ktmizugaki/xiao-minichoc-sample/circuit/KeyboardLibrary/Keyboard.FCStd

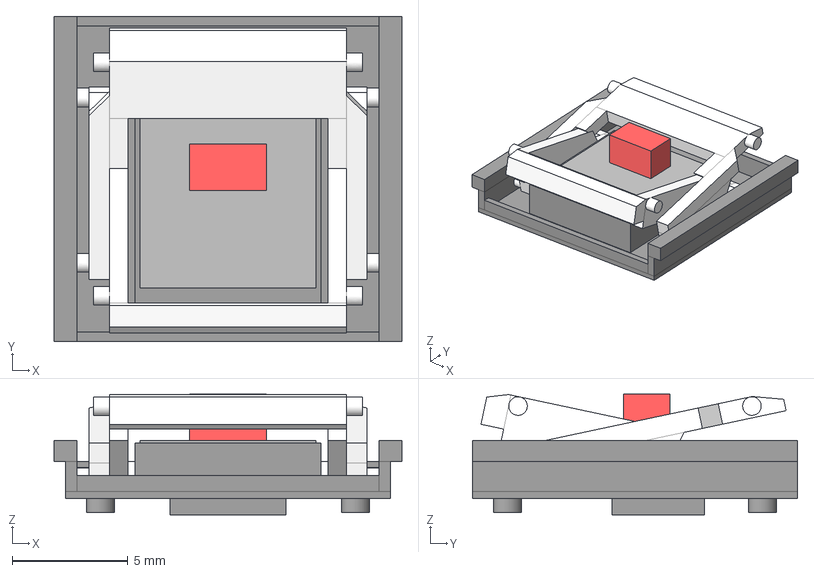
[picture p1: CAD file, 2022-06-24]
circuit/KeyboardLibrary/Keyboard.FCStd
15.0 x 14.0 x 5.20 mm
PG1425_Bottom
PG1425_TopPlate
PG1425_Stem
PG1425_FrontShaft
PG1425_BackShaft
