ktmizugaki/xiao-minichoc-sample/circuit/xiao-minichoc-sample.kicad_pcb

## KiCad design circuit/xiao-minichoc-sample.kicad_pcb (2022-06-24)

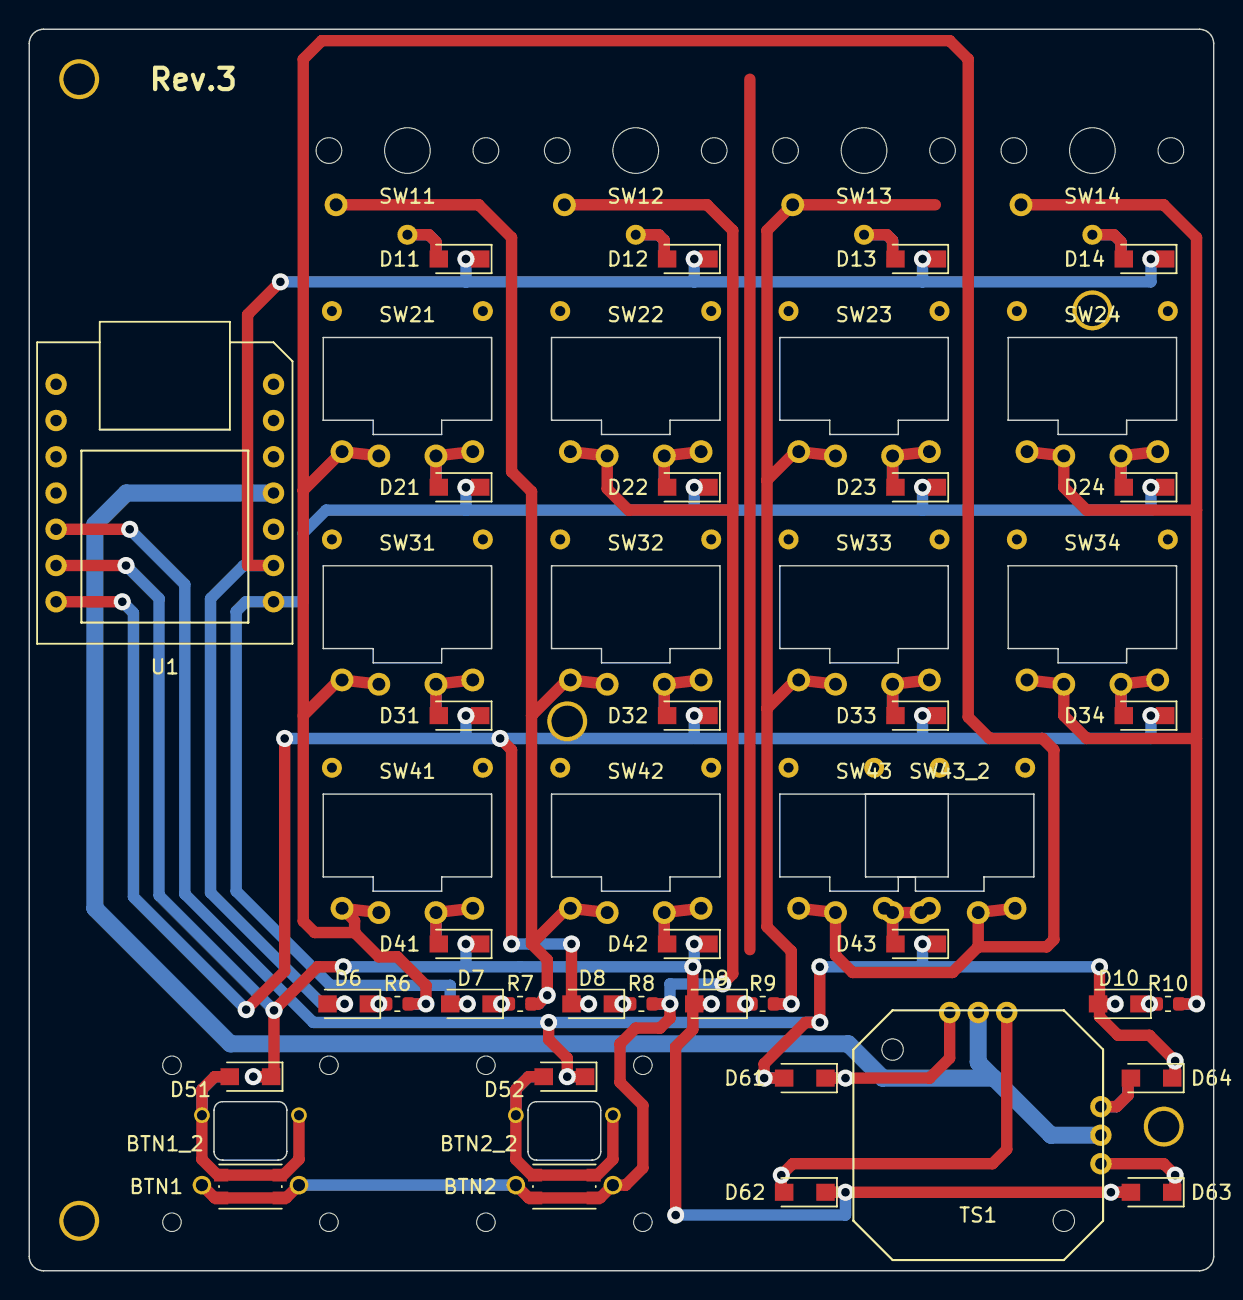
[picture p2: board xiao-minichoc-sample.kicad_pcb from above]

Board: 2 copper layers, 83.0 x 87.0 mm, 58 parts (0 on the bottom side), 37 nets.

Parts:
BTN1: BUTTON1; SW_SPST_KMR2
BTN1_2: BUTTON1; Kailh_X_Switch_PG1425_Reversible
BTN2: BUTTON2; SW_SPST_KMR2
BTN2_2: BUTTON2; Kailh_X_Switch_PG1425_Reversible
D6, D7, D8, D9, D10: 1SS355VM; D_SOD-123-323_Reversible
D11, D12, D13, D14, D21, D22, D23, D24, D31, D32, D33, D34, D41, D42, D43, D51, D52: 1N4148W; D_SOD-123-323_Reversible
D61, D62, D63, D64: SS2040FL; D_SOD-123-323_Reversible
Hole1: Hole1; MountingHole_2.2mm_M2_Pad
Hole2: Hole2; MountingHole_2.2mm_M2_Pad
Hole3: Hole3; MountingHole_2.2mm_M2_Pad
Hole4, Hole4#2: Hole4; MountingHole_2.2mm_M2_Pad
R6, R7, R8, R9, R10: ~~600; R_0603_1608Metric_Reversible
SW11: SW11; Kailh_Choc_V1_PG1350_Reversible
SW12: SW12; Kailh_Choc_V1_PG1350_Reversible
SW13: SW13; Kailh_Choc_V1_PG1350_Reversible
SW14: SW14; Kailh_Choc_V1_PG1350_Reversible
SW21: SW21; Kailh_Choc_Mini_PG1232_Reversible
SW22: SW22; Kailh_Choc_Mini_PG1232_Reversible
SW23: SW23; Kailh_Choc_Mini_PG1232_Reversible
SW24: SW24; Kailh_Choc_Mini_PG1232_Reversible
SW31: SW31; Kailh_Choc_Mini_PG1232_Reversible
SW32: SW32; Kailh_Choc_Mini_PG1232_Reversible
SW33: SW33; Kailh_Choc_Mini_PG1232_Reversible
SW34: SW34; Kailh_Choc_Mini_PG1232_Reversible
SW41: SW41; Kailh_Choc_Mini_PG1232_Reversible
SW42: SW42; Kailh_Choc_Mini_PG1232_Reversible
SW43, SW43_2: SW43; Kailh_Choc_Mini_PG1232_Reversible
TS1: JT8P-3.2T-B10K-1-16Y-2; JT8P-3.2T-B10K-1-16Y
U1: SeeeduinoXIAO; Seeeduino_XIAO_THT_UpsideDown

Connections:
/A0: TS1.x2, TS1.y2, U1.4
/D6: D6.2, D11.1, D12.1, D13.1, D14.1, U1.6
/D7: D7.2, D21.1, D22.1, D23.1, D24.1, U1.7
/D8: D8.2, D31.1, D32.1, D33.1, D34.1, Hole4#2.1, U1.8
/D9: D9.2, D41.1, D42.1, D51.1, D62.1, D63.2, U1.9
/D10: D10.2, D43.1, D52.1, D61.2, D64.1, U1.10
/RD6: R6.2, SW21.1, SW31.1, SW41.1, SW43.1, SW43_2.2
/RD7: R7.2, SW11.2, SW32.1, SW42.1
/RD8: BTN1.1, BTN1_2.1, BTN2.1, BTN2_2.1, R8.2, SW12.2, SW22.1
/RD9: R9.2, SW13.2, SW23.1, SW33.1
/RD10: R10.2, SW14.2, SW24.1, SW34.1
unnamed: BTN1.2, BTN1_2.2, D51.2
unnamed: BTN2.2, BTN2_2.2, D52.2
unnamed: D6.1, R6.1
unnamed: D7.1, R7.1
unnamed: D8.1, R8.1
unnamed: D9.1, R9.1
unnamed: D10.1, R10.1
unnamed: D11.2, SW11.1
unnamed: D12.2, SW12.1
unnamed: D13.2, SW13.1
unnamed: D14.2, SW14.1
unnamed: D21.2, SW21.2
unnamed: D22.2, SW22.2
unnamed: D23.2, SW23.2
unnamed: D24.2, SW24.2
unnamed: D31.2, SW31.2
unnamed: D32.2, SW32.2
unnamed: D33.2, SW33.2
unnamed: D34.2, SW34.2
unnamed: D41.2, SW41.2
unnamed: D42.2, SW42.2
unnamed: D43.2, SW43.2, SW43_2.1
unnamed: D61.1, TS1.x3
unnamed: D62.2, TS1.x1
unnamed: D63.1, TS1.y1
unnamed: D64.2, TS1.y3
