ktmizugaki/xiao-minichoc-sample/MeasureDiode/charlieplex-3io.png

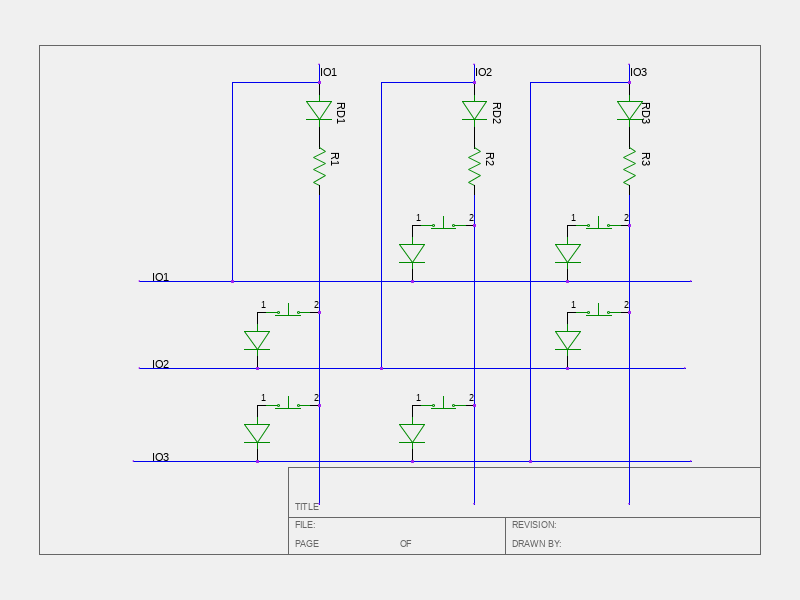
MeasureDiode/charlieplex-3io.png
