ktmizugaki/xiao-minichoc-sample/MeasureDiode/MeasureDiode-sch.png

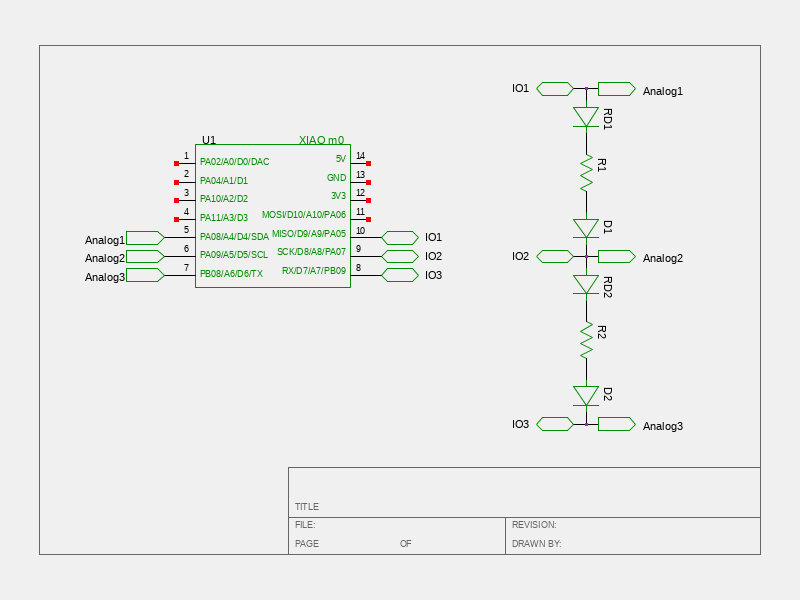
MeasureDiode/MeasureDiode-sch.png
