ktmizugaki/xiao-minichoc-sample/(commit log)

2022-06-24 Add KeyboardLibrary
    [Keyboard.FCStd]
2022-06-24 Add MeasureDiode
    [MeasureDiode.sch]
2022-06-24 Add png version of schematic
    [charlieplex-3io.sch]
2022-10-10 Rework firmware
    - Restructure sources
    - Refine analog handling
    - Support layer
    [kbdconfig.h, keymap.c, stdio.cpp, xiao-minichoc-sample.ino]
